mrksn/presstimer/plots/presstimer__Assembly.pdf

1 | 2 | 3 | 4 | 5 | 6

AB

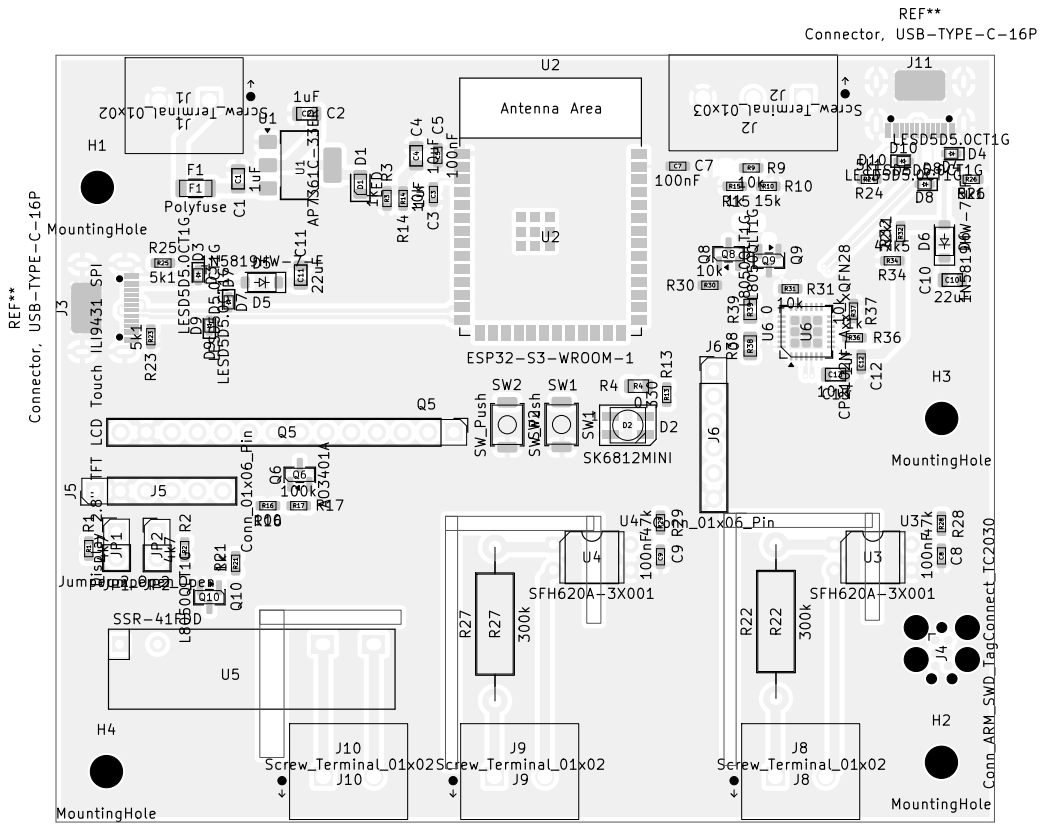
[picture p1: page 1]

Board2Pdf: Black And White TOP - Page 1/2

Sheet: Black And White TOP
File: presstimer.kicad_pcb
Title:

1 | 2 | 3 | 4 | 5 | 6

AB

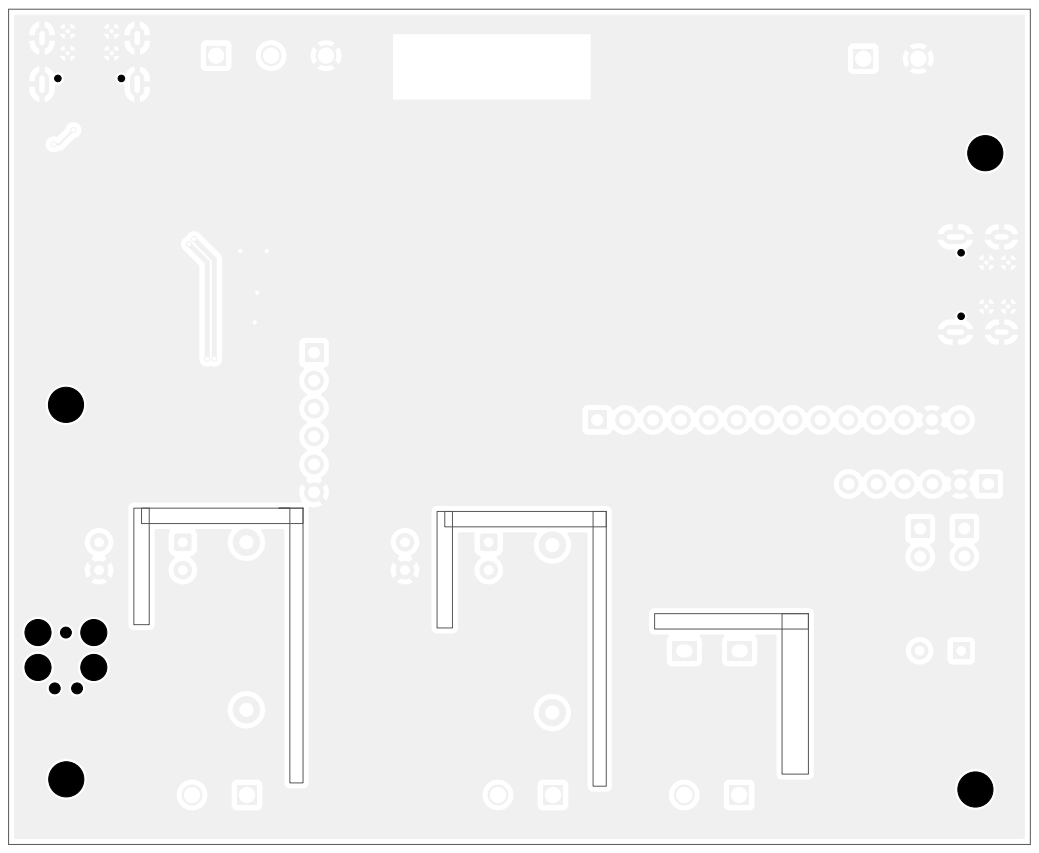
[picture p2: page 2]
D Date:; Size: A4; Rev:

Board2Pdf: Black And White BOT - Page 2/2

Sheet: Black And White BOT
File: presstimer.kicad_pcb
Title:
KiCad E.D.A. 10.0.3
