mrksn/presstimer/presstimer-machine-side.pdf

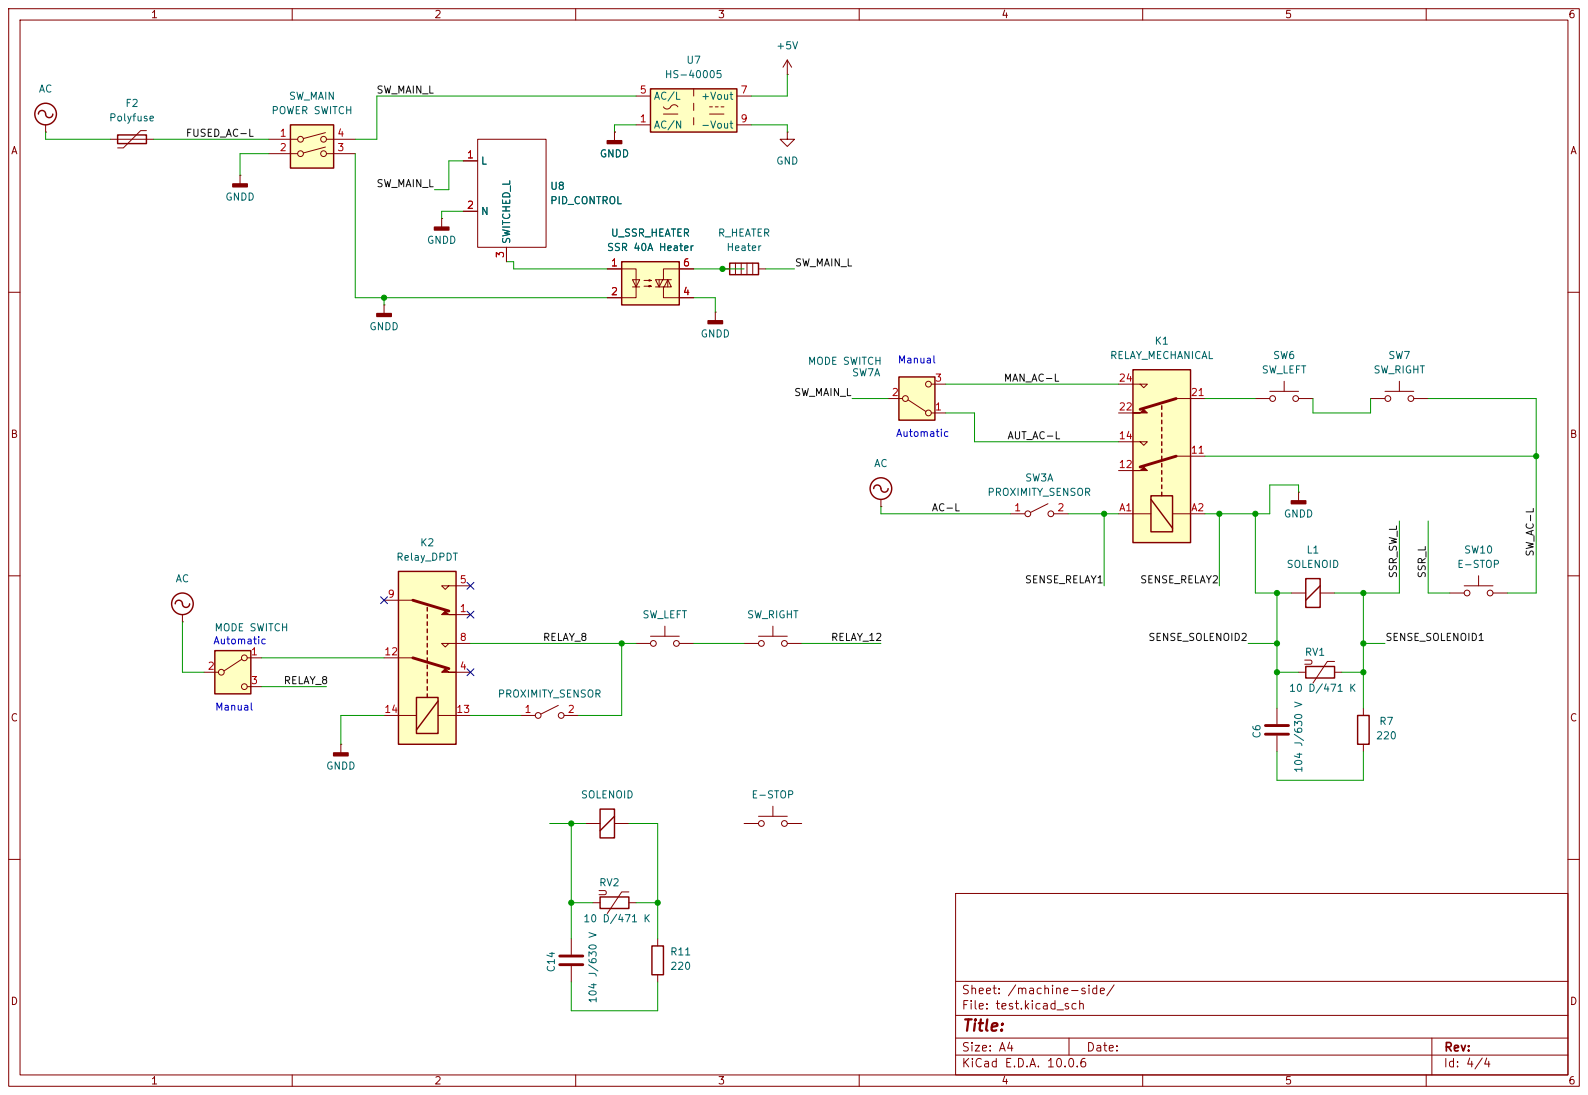
[picture p3: page 1]

Size: A4 | Rev:
KiCad E.D.A. 10.0.6 | Id: 4/4
