mrksn/presstimer/new_plot/presstimer.pdf

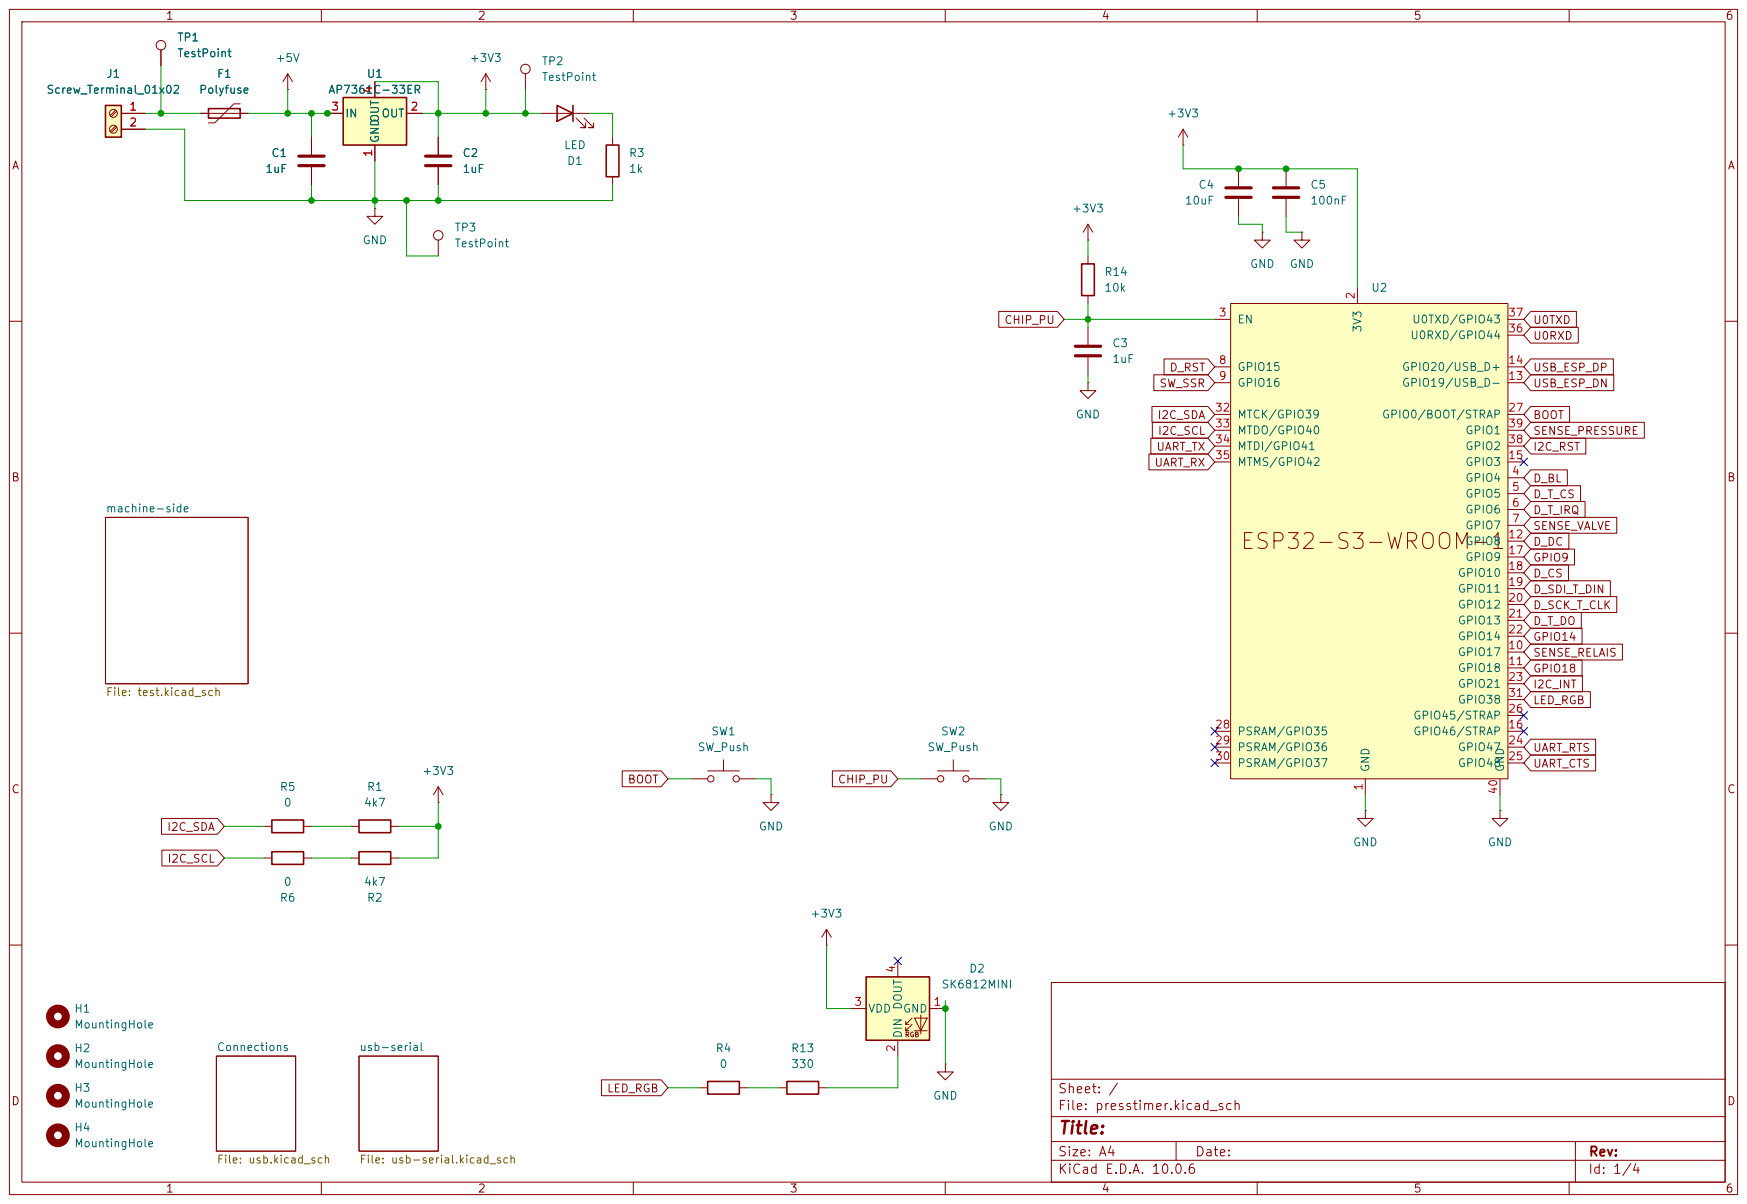
[picture p4: page 1]

usb-serial File: usb-serial.kicad_sch machine-side

Size: A4 | Rev:
KiCad E.D.A. 10.0.6 | Id: 1/4

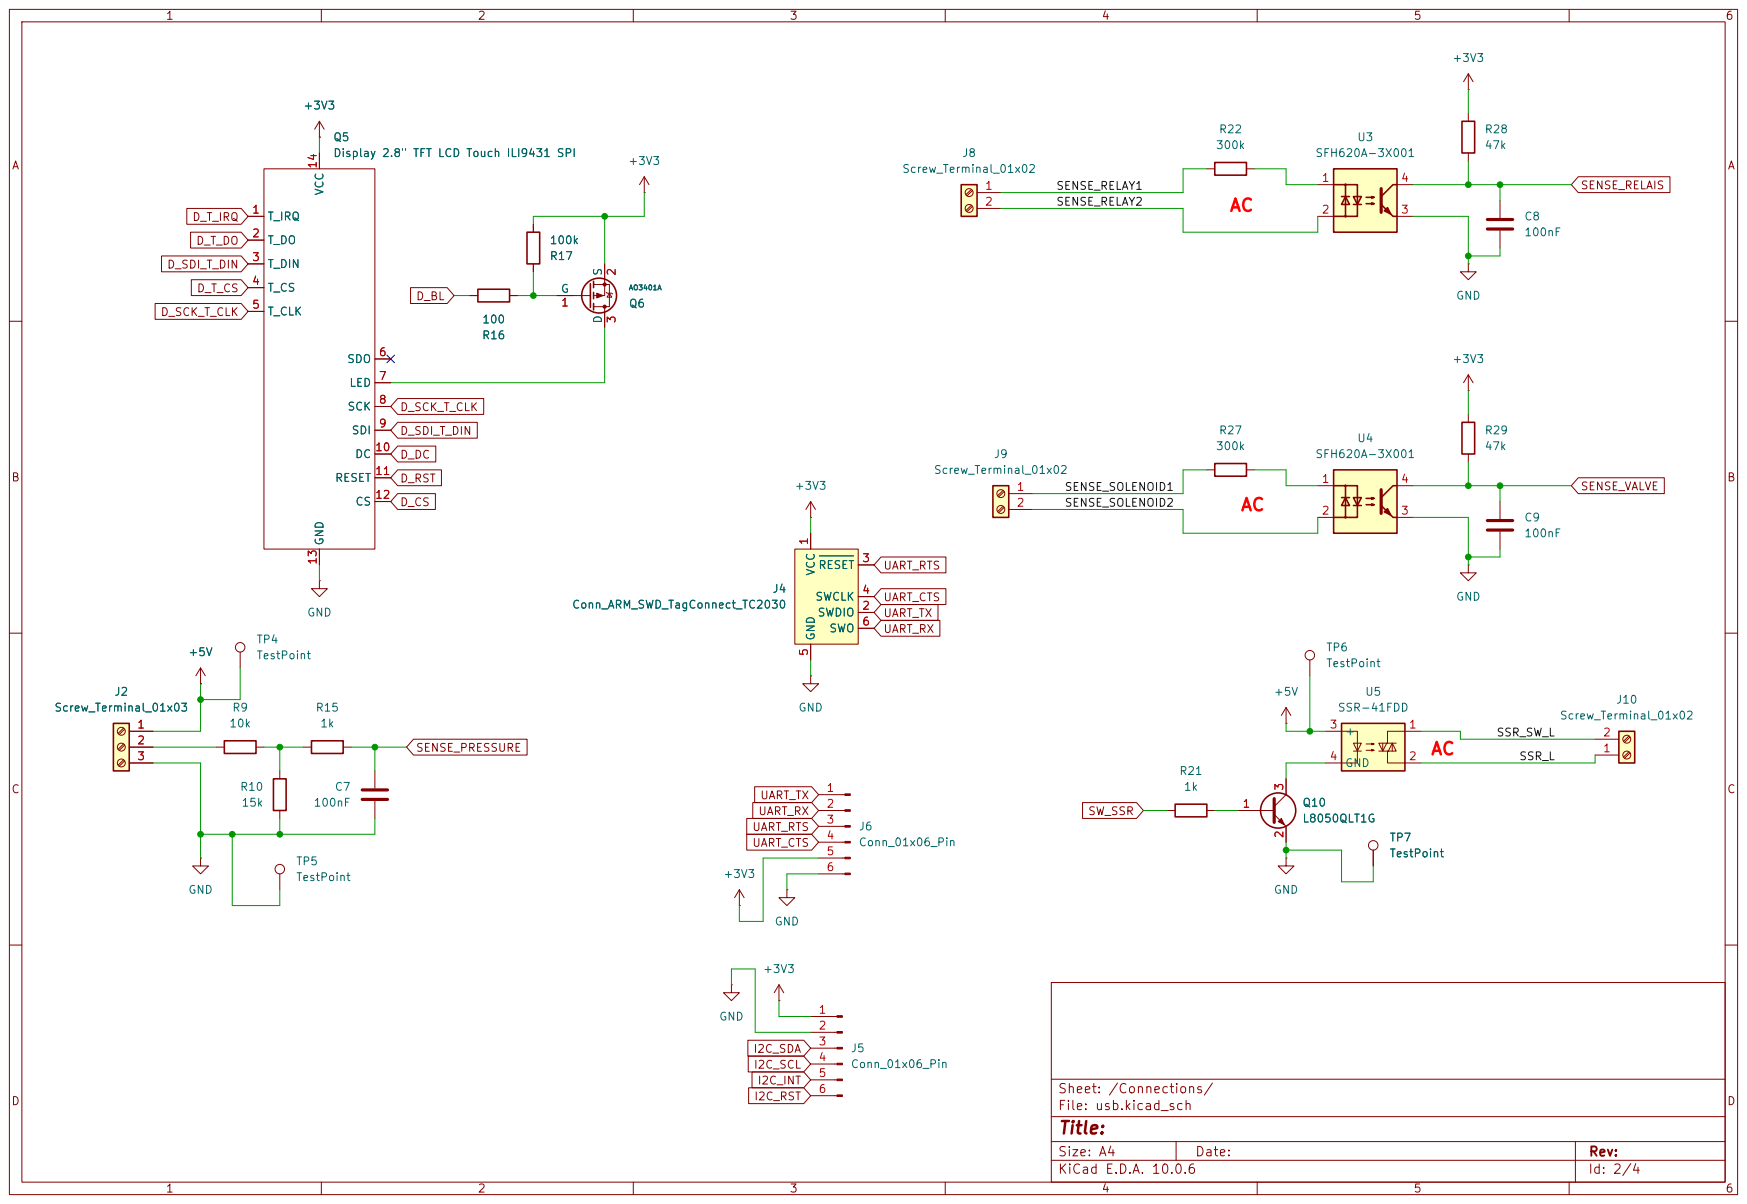
[picture p5: page 2]

100 Q5Display 2.8" TFT LCD Touch ILI9431 SPI T_IRQ 1

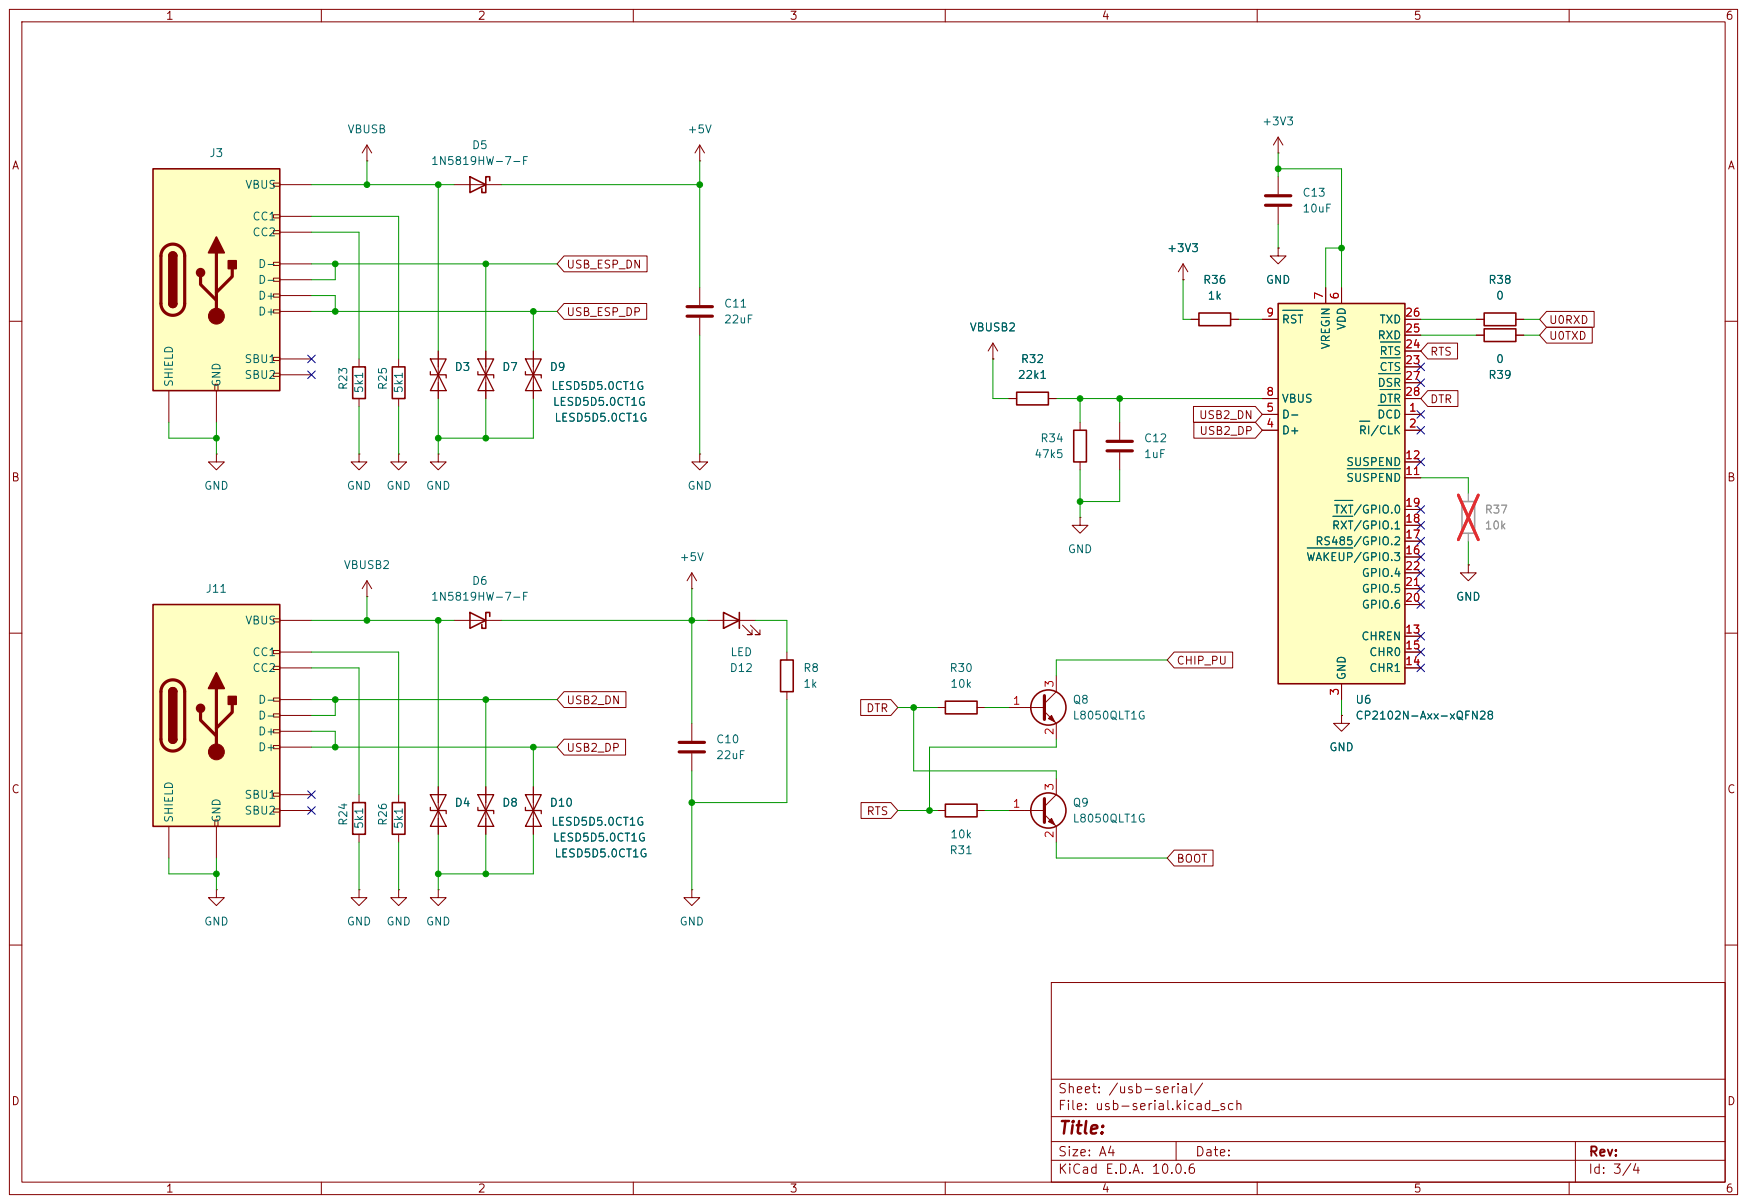
[picture p6: page 3]

SUSPEND 11 SUSPEND 12 CHREN 13 CHR1 14 CHR0 15 WAKEUP/GPIO.3 16 RS485/GPIO.2 17 RXT/GPIO.1 18 TXT/GPIO.0 19 GPIO.6 20 GPIO.5 21 GPIO.4 22 CTS 23 RTS 24 RXD 25 TXD 26 DSR 27 DTR 28 U6CP2102N-Axx-xQFN28R37

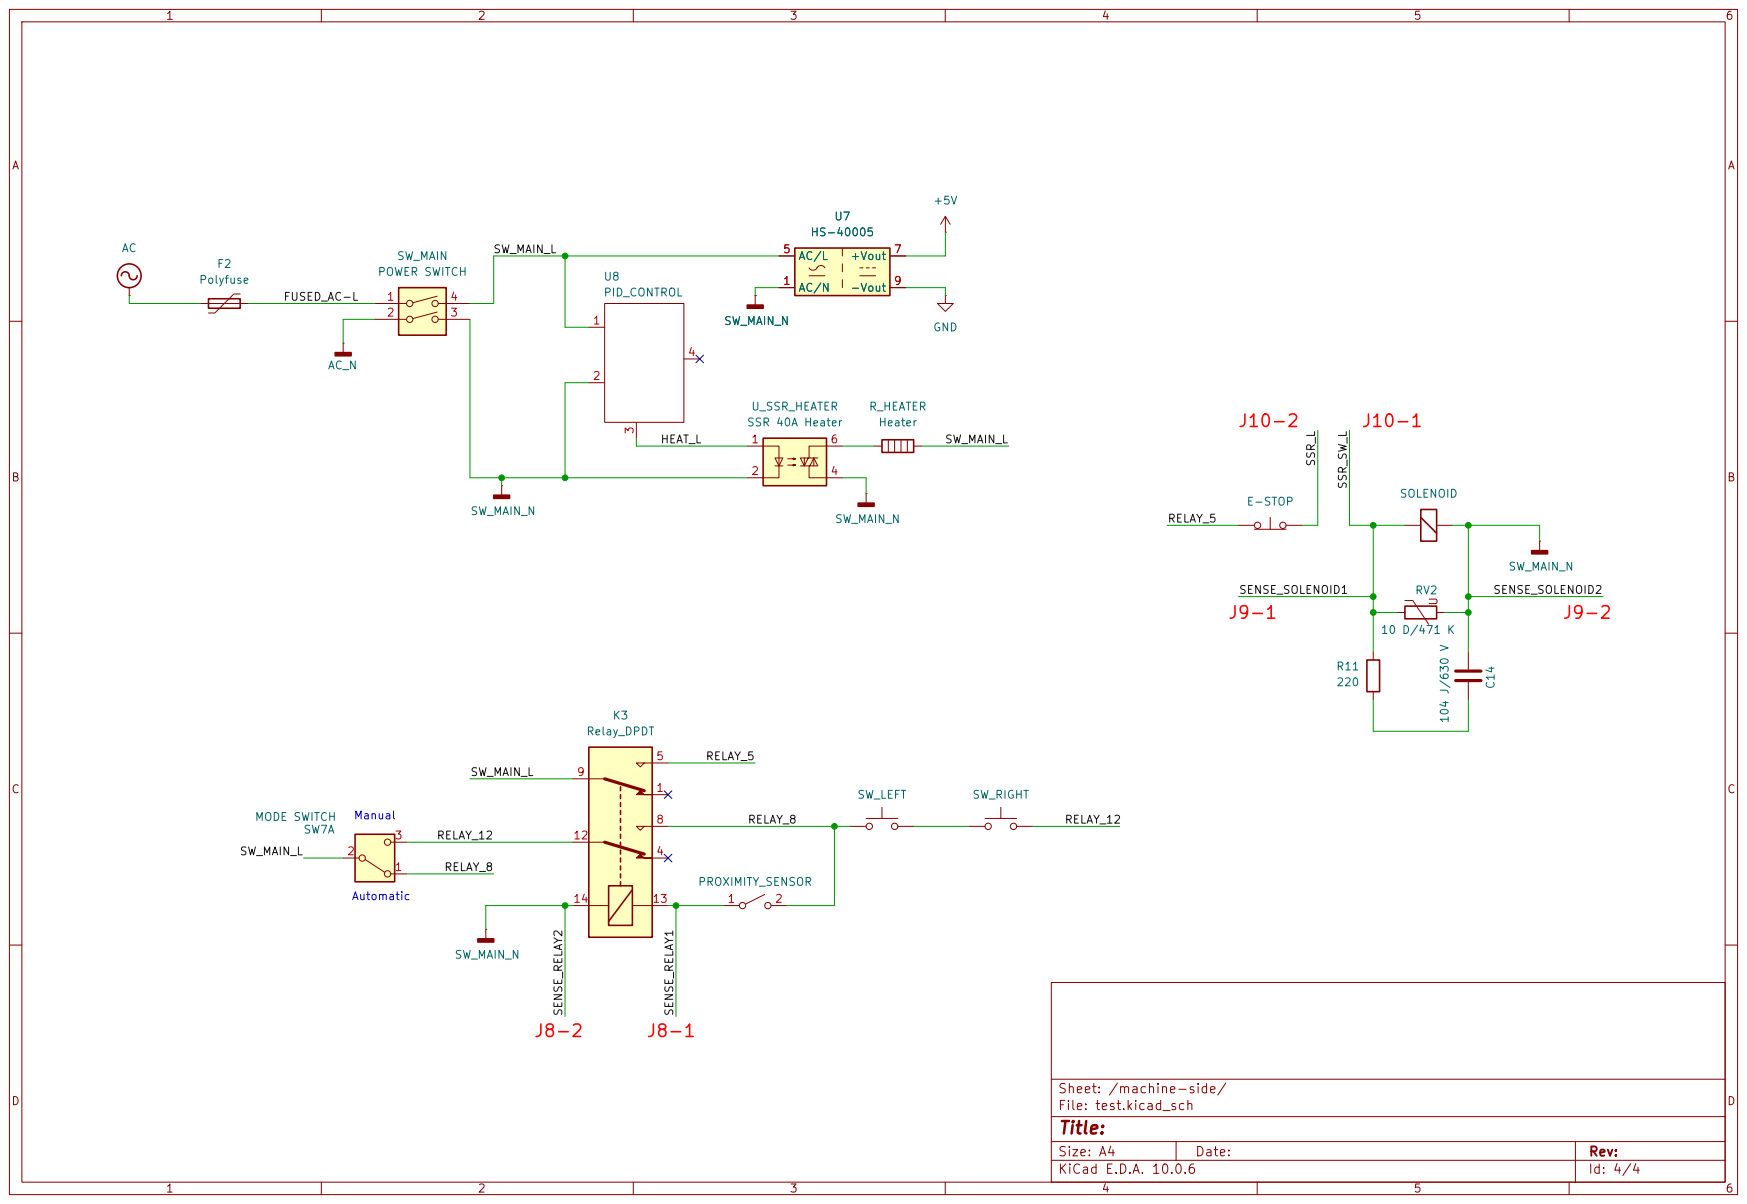
[picture p7: page 4]
