mrksn/presstimer/presstimer.kicad_pcb

## KiCad design presstimer.kicad_pcb (2026-09-20)

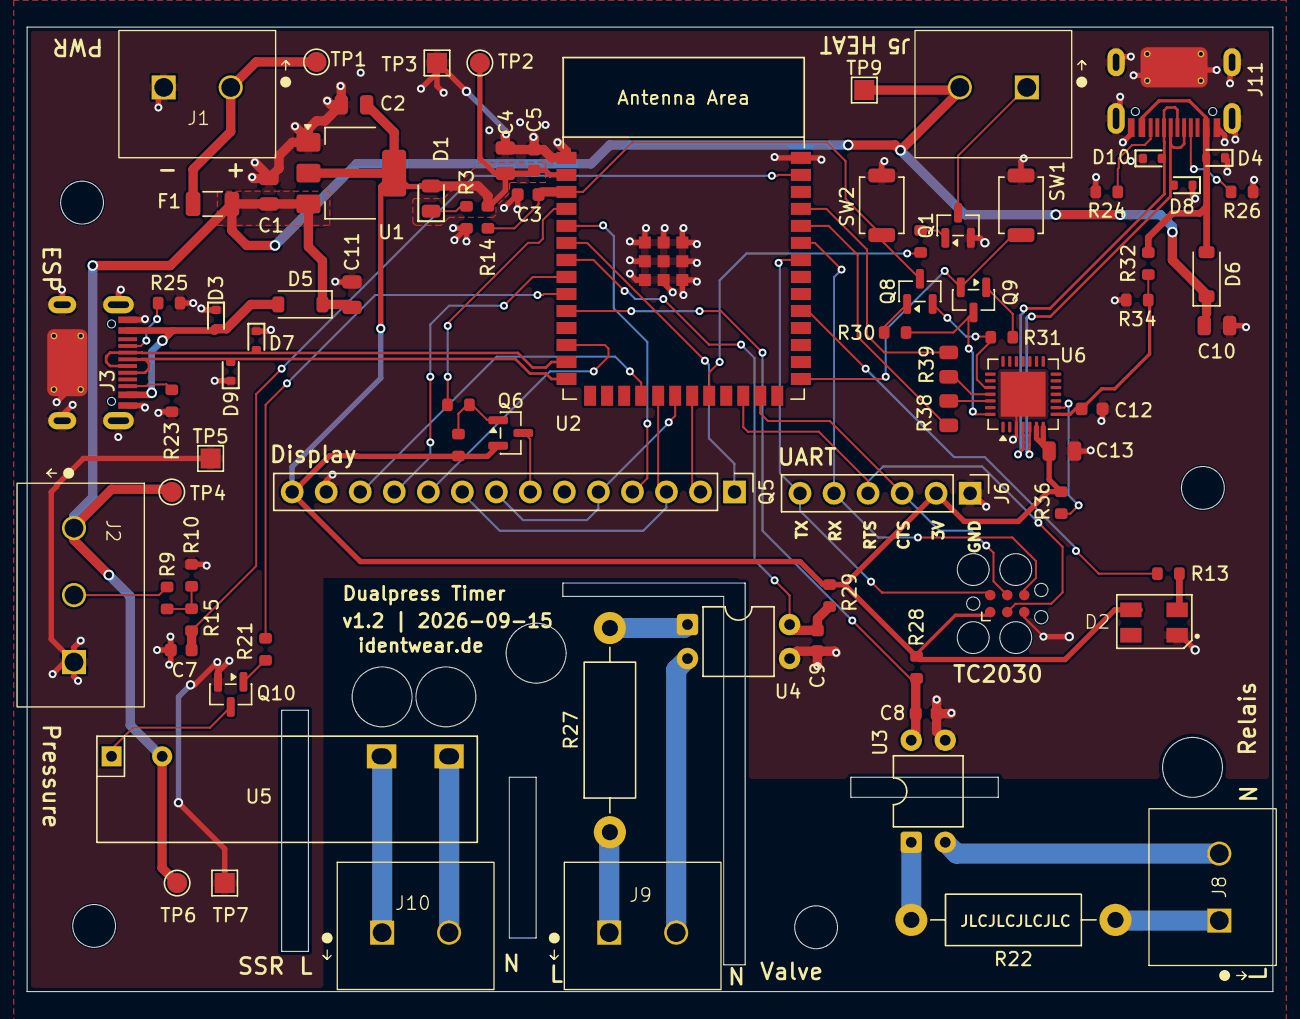
[picture p11: board presstimer.kicad_pcb from above]

Board: 4 copper layers, 93.0 x 72.0 mm, 84 parts (0 on the bottom side), 63 nets.

Parts:
C1, C2: 1uF; C_0805
C3, C12: 1uF; C_0603
C4, C13: 10uF; C_0805
C5, C7, C8, C9: 100nF; C_0603
C10, C11: 22uF; C_0805
D1: LED; D_0805
D2: SK6812MINI; SK6812MINI--HS-012_3.7x3.5mm
D3, D4, D7, D8, D9, D10: LESD5D5.0CT1G; D_SOD-523
D5, D6: 1N5819HW-7-F; D_SOD-123
F1: Polyfuse; 1206L300SL16ARG
H1, H2, H3, H4: MountingHole; MountingHole_3.2mm_M3
J1, J5, J8, J9, J10: Screw_Terminal_01x02; DG305-5.0-02P-12-00A(H)
J2: Screw_Terminal_01x03; DG305-5.0-03P-12-00A(H)
J3, J11: Connector, USB-TYPE-C-16P; TYPE-C-SMD_HX-TYPE-C-16PIN
J4: Conn_ARM_SWD_TagConnect_TC2030; Tag-Connect_TC2030-IDC-FP_2x03_P1.27mm_Vertical
J6: Conn_01x06_Pin; PinHeader_1x06_P2.54mm_Vertical
Q1, Q8, Q9, Q10: L8050QLT1G; SOT-23
Q5: Display 2.8" TFT LCD Touch ILI9431 SPI; PinHeader_1x14_P2.54mm_Vertical
Q6: AO3401A; SOT-23
R1, R3, R15, R21, R36: 1k; R_0603
R9, R14, R30, R31: 10k; R_0603
R10: 15k; R_0603
R13: 330; R_0603
R16: 100; R_0603
R17: 100k; R_0603
R22, R27: 300k; R_Axial_DIN0411_L9.9mm_D3.6mm_P15.24mm_Horizontal
R23, R24, R25, R26: 5k1; R_0603
R28, R29: 47k; R_0603
R32: 22k1; R_0603
R34: 47k5; R_0603
R38, R39: 0; R_0805
SW1, SW2: SW_Push; SW_SPST_TS-1088-xR025
TP1, TP2, TP4, TP6: TestPoint; TestPoint_Pad_D1.5mm
TP3, TP5, TP7, TP9: TestPoint; TestPoint_Pad_1.5x1.5mm
U1: AP7361C-33ER; SOT-223R
U2: ESP32-S3-WROOM-1
U3, U4: SFH620A-3X001; DIP-4_W7.62mm
U5: SSR-41FDA; SSR-41FDD
U6: CP2102N-Axx-xQFN28; QFN-28-1EP_5x5mm_P0.5mm_EP3.35x3.35mm

Connections:
+3V3: C2.1, C4.1, C5.1, C13.1, D1.2 (A), D2.3 (VDD), J4.1 (VCC), J6.2, Q5.14 (VCC), Q6.2 (S), R14.2, R17.1, R28.1, R29.1, R36.1, TP2.1 (1_1), U1.2 (OUT), U1.4 (OUT), U2.2 (3V3), U6.6 (VDD), U6.7 (VREGIN)
+5V: C1.1, C10.1, C11.1, D5.1 (K), D6.1 (K), F1.2, J2.1, J5.2, TP4.1 (1_1), TP6.1 (1_1), TP9.1 (1_1), U1.3 (IN), U5.3 (+)
/Connections/SENSE_RELAY1: J8.1, R22.1
/Connections/SENSE_RELAY2: J8.2, U3.2
/Connections/SENSE_SOLENOID1: J9.1, R27.1
/Connections/SENSE_SOLENOID2: J9.2, U4.2
/Connections/SSR_L: J10.1, U5.2
/Connections/SSR_SW_L: J10.2, U5.1
BOOT: Q9.2 (E), SW1.1, U2.27 (GPIO0/BOOT/STRAP)
CHIP_PU: C3.1, Q8.3 (C), R14.1, SW2.1, U2.3 (EN)
DTR: Q9.3 (C), R30.1, U6.28 (~DTR)
D_BL: R16.1, U2.4 (GPIO4)
D_CS: Q5.12 (CS), U2.18 (GPIO10)
D_DC: Q5.10 (DC), U2.12 (GPIO8)
D_RST: Q5.11 (RESET), U2.8 (GPIO15)
D_SCK_T_CLK: Q5.5 (T_CLK), Q5.8 (SCK), U2.20 (GPIO12)
D_SDI_T_DIN: Q5.3 (T_DIN), Q5.9 (SDI), U2.19 (GPIO11)
D_T_CS: Q5.4 (T_CS), U2.5 (GPIO5)
D_T_DO: Q5.2 (T_DO), U2.21 (GPIO13)
D_T_IRQ: Q5.1 (T_IRQ), U2.6 (GPIO6)
GND: C1.2, C2.2, C3.2, C4.2, C5.2, C7.2, C8.2, C9.2, C10.2, C11.2, C12.2, C13.2, D2.1 (GND), D3.1 (A1), D4.1 (A1), D7.1 (A1), D8.1 (A1), D9.1 (A1), D10.1 (A1), J1.2, J2.3, J3.A12B1 (GND), J3.B12A1 (GND), J3.S1 (SHIELD), J4.5 (GND), J6.1, J11.A12B1 (GND), J11.B12A1 (GND), J11.S1 (SHIELD), Q1.2 (E), Q5.13 (GND), Q10.2 (E), R3.2, R10.2, R23.2, R24.2, R25.2, R26.2, R34.2, SW1.2, SW2.2, TP3.1 (1_1), TP5.1 (1_1), TP7.1 (1_1), U1.1 (GND), U2.1 (GND), U2.40 (GND), U2.41 (GND), U3.3, U4.3, U6.3 (GND), U6.29 (GND)
GPIO14: R1.1, U2.22 (GPIO14)
LED_RGB: R13.1, U2.31 (GPIO38)
unnamed: D1.1 (K), R3.1
unnamed: D2.2 (DIN), R13.2
unnamed: F1.1, J1.1, TP1.1 (1_1)
unnamed: J2.2, R9.2
unnamed: J3.A5 (CC1), R25.1
unnamed: J3.B5 (CC2), R23.1
unnamed: J5.1, Q1.3 (C)
unnamed: J11.A5 (CC1), R26.1
unnamed: J11.B5 (CC2), R24.1
unnamed: Q1.1 (B), R1.2
unnamed: Q5.7 (LED), Q6.3 (D)
unnamed: Q6.1 (G), R16.2, R17.2
unnamed: Q8.1 (B), R30.2
unnamed: Q9.1 (B), R31.2
unnamed: Q10.1 (B), R21.2
unnamed: Q10.3 (C), U5.4 (GND)
unnamed: R9.1, R10.1, R15.2
unnamed: R22.2, U3.1
unnamed: R27.2, U4.1
unnamed: R39.1, U6.25 (RXD)
unnamed: R38.1, U6.26 (TXD)
unnamed: C12.1, R32.2, R34.1, U6.8 (VBUS)
unnamed: R36.2, U6.9 (~RST)
RTS: Q8.2 (E), R31.1, U6.24 (~RTS)
SENSE_PRESSURE: C7.1, R15.1, U2.39 (GPIO1)
SENSE_RELAIS: C8.1, R28.2, U2.10 (GPIO17), U3.4
SENSE_VALVE: C9.1, R29.2, U2.7 (GPIO7), U4.4
SW_SSR: R21.1, U2.9 (GPIO16)
U0RXD: R38.2, U2.36 (U0RXD/GPIO44)
U0TXD: R39.2, U2.37 (U0TXD/GPIO43)
UART_CTS: J4.4 (SWCLK), J6.3, U2.25 (GPIO48)
UART_RTS: J4.3 (~RESET), J6.4, U2.24 (GPIO47)
UART_RX: J4.6 (SWO), J6.5, U2.35 (MTMS/GPIO42)
UART_TX: J4.2 (SWDIO), J6.6, U2.34 (MTDI/GPIO41)
USB2_DN: D8.2 (A2), J11.A7 (D-), J11.B7 (D-), U6.5 (D-)
USB2_DP: D10.2 (A2), J11.A6 (D+), J11.B6 (D+), U6.4 (D+)
USB_ESP_DN: D7.2 (A2), J3.A7 (D-), J3.B7 (D-), U2.13 (GPIO19/USB_D-)
USB_ESP_DP: D9.2 (A2), J3.A6 (D+), J3.B6 (D+), U2.14 (GPIO20/USB_D+)
VBUSB: D3.2 (A2), D5.2 (A), J3.A9B4 (VBUS), J3.B9A4 (VBUS)
VBUSB2: D4.2 (A2), D6.2 (A), J11.A9B4 (VBUS), J11.B9A4 (VBUS), R32.1
