mrksn/presstimer/(commit log)

2026-06-19 schematic done
    [presstimer.kicad_pcb, presstimer.kicad_sch, usb.kicad_sch]
2026-06-19 footprints added, pcb started
    [presstimer.kicad_pcb, presstimer.kicad_sch, usb.kicad_sch]
2026-06-19 usb-uart added to schematic
    [presstimer.kicad_sch, usb-serial.kicad_sch]
2026-06-20 added usb-serial programmer and footprints
    [presstimer.kicad_pcb, presstimer.kicad_sch, usb-serial.kicad_sch]
2026-06-21 before removing footprints
    [presstimer.kicad_pcb, usb.kicad_sch]
2026-06-21 before restore, crashed session
    [presstimer.kicad_pcb]
2026-06-21 parts assigned, footprints checked
    [presstimer.kicad_pcb, presstimer.kicad_sch, usb-serial.kicad_sch, usb.kicad_sch]
2026-06-21 started pcb layout
    [presstimer.kicad_pcb, presstimer.kicad_sch, usb-serial.kicad_sch, usb.kicad_sch]
2026-06-22 pcb layout v0.0.2
    [presstimer-CuBottom.gbr, presstimer-CuIn1.gbr, presstimer-CuIn2.gbr, presstimer-CuTop.gbr, presstimer-EdgeCuts.gbr, presstimer-MaskBottom.gbr, presstimer-MaskTop.gbr, presstimer-NPTH.drl]
2026-06-22 pcb layout v0.0.3 (i forgot the second signal layer ;(.
    [presstimer.kicad_pcb]
2026-06-22 start over routing
    [presstimer.kicad_pcb]
2026-06-22 routing finished v0.1.0
    [presstimer-CuBottom.gbr, presstimer-CuIn1.gbr, presstimer-CuIn2.gbr, presstimer-CuTop.gbr, presstimer-EdgeCuts.gbr, presstimer-MaskBottom.gbr, presstimer-MaskTop.gbr, presstimer-NPTH.drl]
2026-06-23 board finished v1.0
    [presstimer-CuBottom.gbr, presstimer-CuIn1.gbr, presstimer-CuIn2.gbr, presstimer-CuTop.gbr, presstimer-EdgeCuts.gbr, presstimer-MaskBottom.gbr, presstimer-MaskTop.gbr, presstimer-NPTH.drl]
2026-06-26 html bom created
    [presstimer-CuBottom.gbr, presstimer-CuIn1.gbr, presstimer-CuIn2.gbr, presstimer-CuTop.gbr, presstimer-EdgeCuts.gbr, presstimer-MaskBottom.gbr, presstimer-MaskTop.gbr, presstimer-NPTH.drl]
2026-07-19 fix: corrected 3v3 connections at D5, USB power to LDO, power to I2C expansion
    [presstimer.kicad_pcb, presstimer.kicad_sch, usb-serial.kicad_sch]
2026-09-15 fixed ssr pinout
    [presstimer-CuBottom.gbr, presstimer-CuIn1.gbr, presstimer-CuIn2.gbr, presstimer-CuTop.gbr, presstimer-EdgeCuts.gbr, presstimer-MaskBottom.gbr, presstimer-MaskTop.gbr, presstimer-NPTH.drl]
2026-09-20 before removal of cp2102
    [GPIO_ASSIGNMENTS.ods, presstimer.kicad_pcb, presstimer.kicad_sch, test.kicad_sch, usb-serial.kicad_sch, usb.kicad_sch]
2026-09-20 add: connector heating SSR
    [presstimer.kicad_pcb, presstimer.kicad_sch, test.kicad_sch, usb-serial.kicad_sch, usb.kicad_sch]
2026-09-22 chore: update KiCad designator ordering
